shachi-lab/jjy_sim/hardware/case_3d/r3/JJY_SIM_R3_Bottom.png

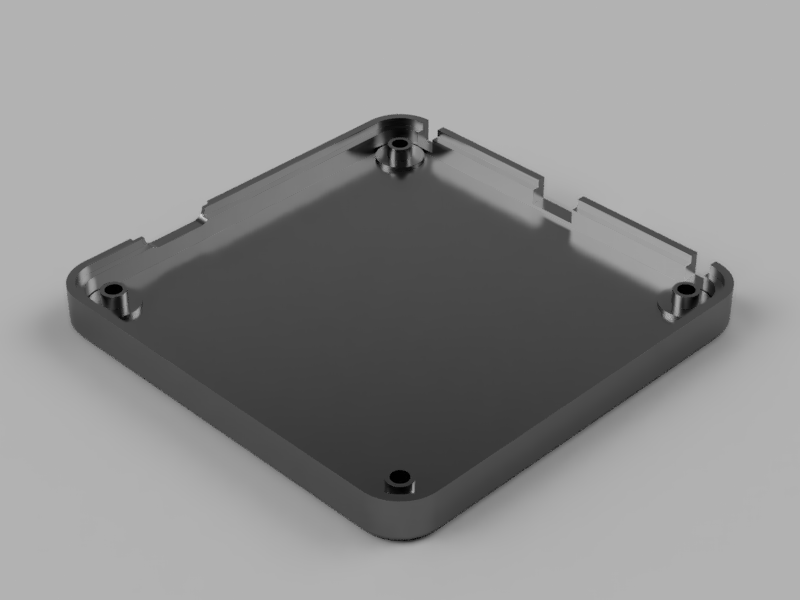
hardware/case_3d/r3/JJY_SIM_R3_Bottom.png
