shachi-lab/jjy_sim/hardware/case_3d/r3/JJY_SIM_R3_Top.step

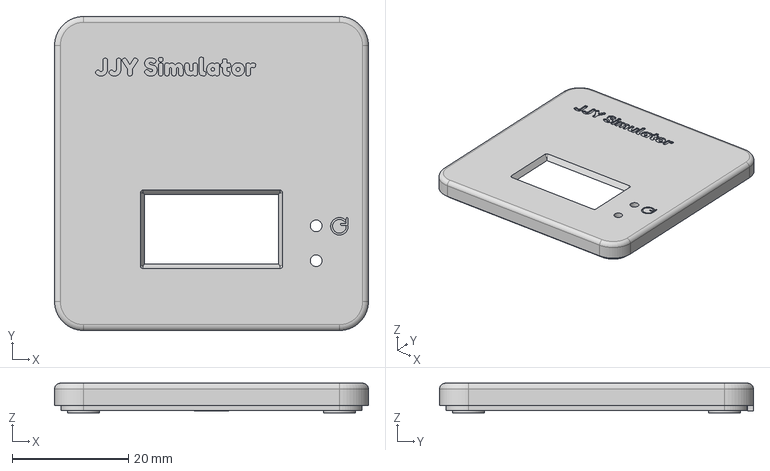
[picture p6: CAD file, 2026-10-26]
hardware/case_3d/r3/JJY_SIM_R3_Top.step
54.0 x 54.0 x 5.10 mm
