shachi-lab/jjy_sim/hardware/case_3d/r4/JJY_SIM_R4_Top.step

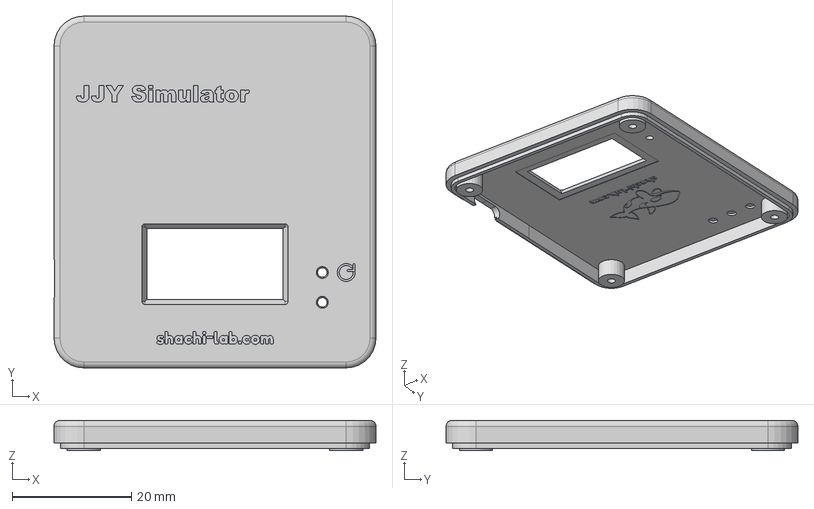
[picture p7: CAD file, 2026-10-26]
hardware/case_3d/r4/JJY_SIM_R4_Top.step
54.0 x 59.0 x 5.10 mm
