shachi-lab/jjy_sim/hardware/KiCad/r4/jjy_sim_r4.kicad_pcb

## KiCad design hardware/KiCad/r4/jjy_sim_r4.kicad_pcb (2026-10-26)

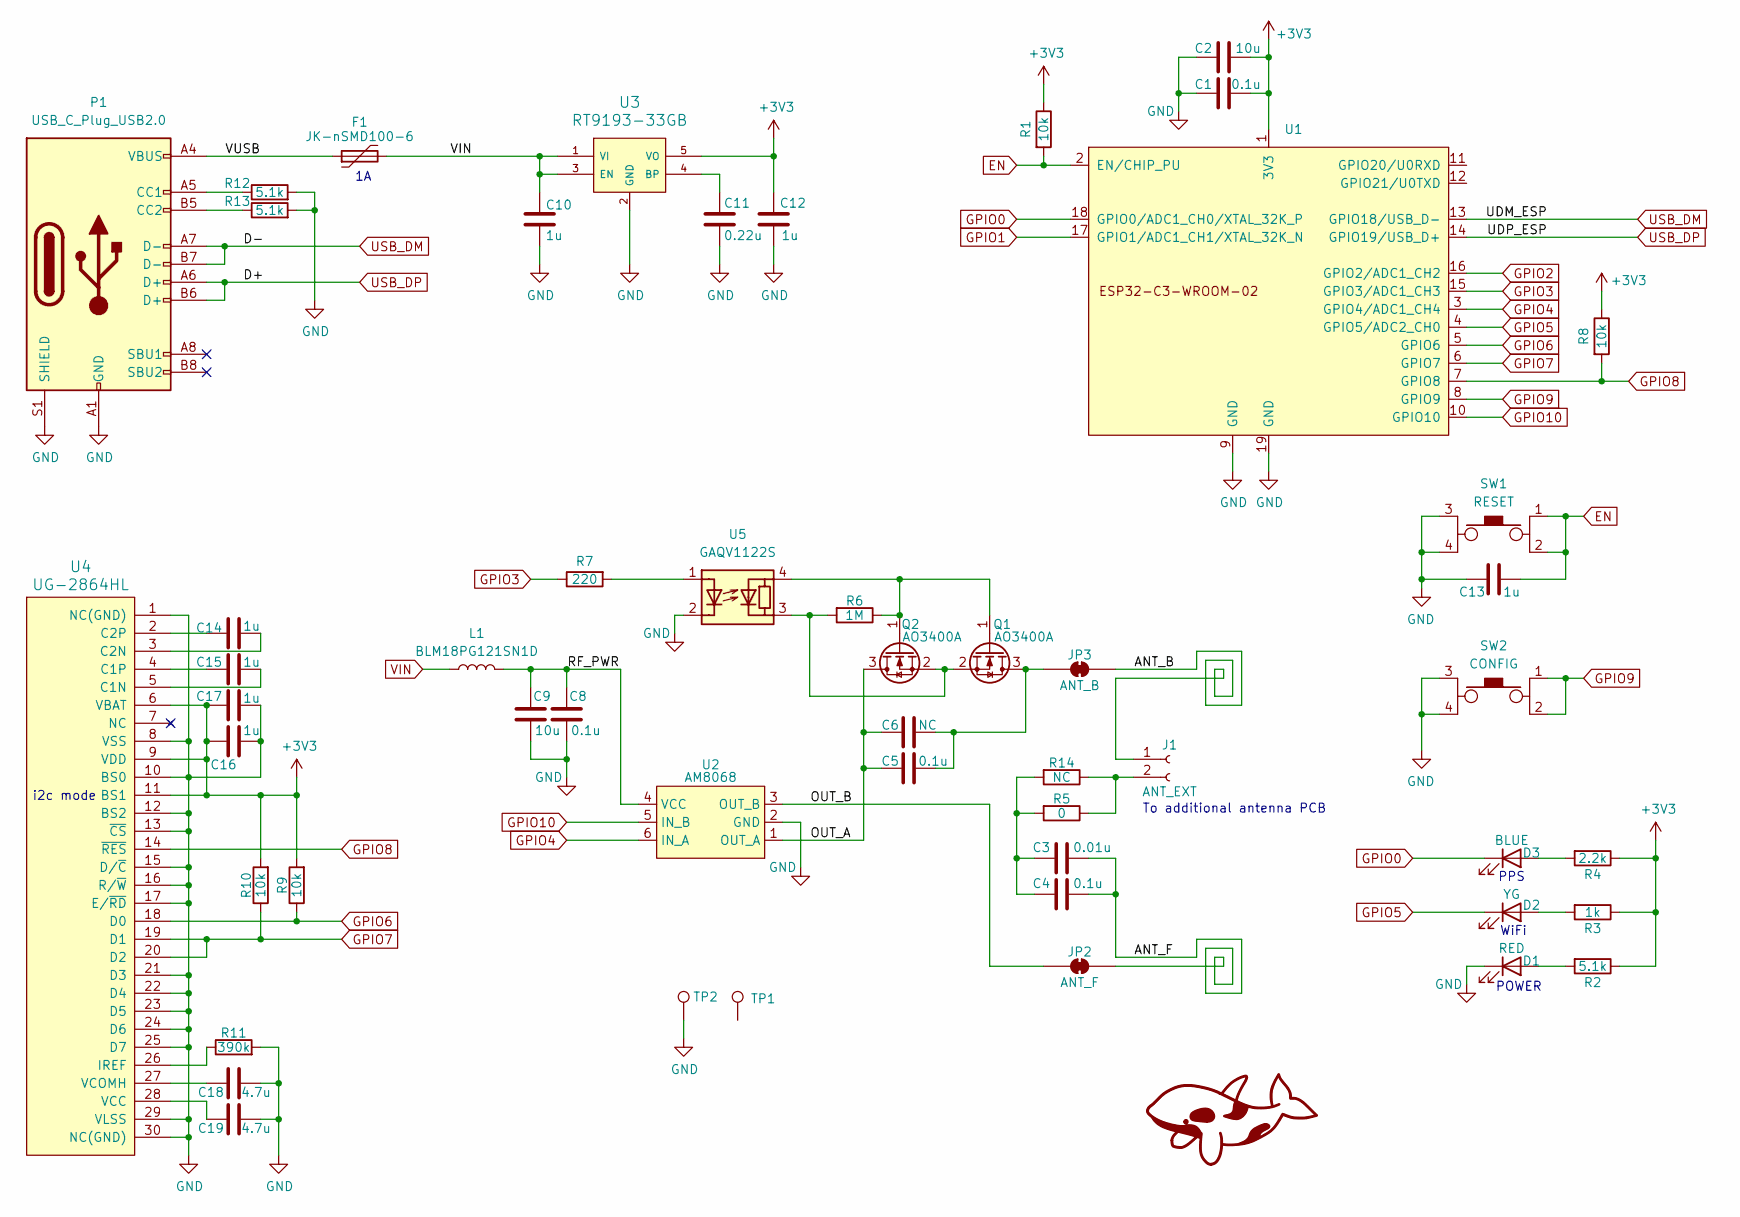
[picture p10: schematic jjy_sim_r4.kicad_sch, JJY Simulator R4]

Parts:
C1, C4, C5, C8: 0.1u; C_0603_1608Metric
C2, C9: 10u; C_0805_2012Metric
C3: 0.01u; C_0603_1608Metric
C6: NC; C_0603_1608Metric
C10, C12, C13, C14, C15, C16, C17: 1u; C_0603_1608Metric
C11: 0.22u; C_0603_1608Metric
C18, C19: 4.7u; C_0603_1608Metric
D1: RED; LED_0603_1608Metric
D2: YG; LED_0603_1608Metric
D3: BLUE; LED_0603_1608Metric
F1: JK-nSMD100-6; Fuse_1206_3216Metric
J1: ANT_EXT; PinHeader_1x02_P2.00mm_Vertical
JP2: ANT_F; SolderJumper-2_P1.3mm_Bridged2Bar_RoundedPad1.0x1.5mm
JP3: ANT_B; SolderJumper-2_P1.3mm_Bridged2Bar_RoundedPad1.0x1.5mm
L1: BLM18PG121SN1D; L_0603_1608Metric
P1: USB_C_Plug_USB2.0; 5077CR-16SMC2-BK-TR
Q1, Q2: AO3400A; SOT-23
R1, R8, R9, R10: 10k; R_0603_1608Metric
R2, R12, R13: 5.1k; R_0603_1608Metric
R3: 1k; R_0603_1608Metric
R4: 2.2k; R_0603_1608Metric
R5: 0; R_0603_1608Metric
R6: 1M; R_0603_1608Metric
R7: 220; R_0603_1608Metric
R11: 390k; R_0603_1608Metric
R14: NC; R_2512_6332Metric
SW1: RESET; SKRPACE010
SW2: CONFIG; SKRPACE010
TP1, TP2: ANT_EX; TestPoint_THTPad_D1.0mm_Drill0.5mm
U1: ESP32-C3-WROOM-02
U2: AM8068; SOT-23-6
U3: RT9193-33GB; SOT-23-5
U4: UG-2864HL; UG-2864-FPC (Reverse)
U5: GAQV1122S; SOP-4_3.8x4.1mm_P2.54mm

Connections:
+3V3: C1.2, C2.2, C12.1, C16.1, C17.1, R1.1, R2.1, R3.1, R4.1, R8.1, R9.2, R10.2, U1.1 (3V3), U3.5 (VO), U4.6 (VBAT), U4.9 (VDD), U4.11 (BS1)
/ANT_B: J1.1, JP3.2 (B)
/ANT_F: C3.2, C4.2, JP2.2 (B)
/OUT_A: C5.1, C6.1, Q2.3 (D), U2.1 (OUT_A)
/OUT_B: JP2.1 (A), U2.3 (OUT_B)
/RF_PWR: C8.1, C9.1, L1.2, U2.4 (VCC)
/VUSB: F1.1, P1.A4 (VBUS), P1.A9 (VBUS), P1.B4 (VBUS), P1.B9 (VBUS)
EN: C13.2, R1.2, SW1.1, SW1.2, U1.2 (EN/CHIP_PU)
GND: C1.1, C2.1, C8.2, C9.2, C10.2, C11.2, C12.2, C13.1, C16.2, C17.2, C18.2, C19.2, D1.1 (K), P1.A1 (GND), P1.A12 (GND), P1.B1 (GND), P1.B12 (GND), P1.S1 (SHIELD), R11.2, R12.2, R13.2, SW1.3, SW1.4, SW2.3, SW2.4, TP2.1 (1_1), U1.9 (GND), U1.19 (GND), U2.2 (GND), U3.2 (GND), U4.1 (NC(GND)), U4.8 (VSS), U4.10 (BS0), U4.12 (BS2), U4.13 (~CS), U4.15 (D/~C), U4.16 (R/~W), U4.17 (E/~RD), U4.21 (D3), U4.22 (D4), U4.23 (D5), U4.24 (D6), U4.25 (D7), U4.29 (VLSS), U4.30 (NC(GND)), U5.2 (K)
GPIO0: D3.1 (K), U1.18 (GPIO0/ADC1_CH0/XTAL_32K_P)
GPIO1: U1.17 (GPIO1/ADC1_CH1/XTAL_32K_N)
GPIO2: U1.16 (GPIO2/ADC1_CH2)
GPIO3: R7.1, U1.15 (GPIO3/ADC1_CH3)
GPIO4: U1.3 (GPIO4/ADC1_CH4), U2.6 (IN_A)
GPIO5: D2.1 (K), U1.4 (GPIO5/ADC2_CH0)
GPIO6: R9.1, U1.5 (GPIO6), U4.18 (D0)
GPIO7: R10.1, U1.6 (GPIO7), U4.19 (D1), U4.20 (D2)
GPIO8: R8.2, U1.7 (GPIO8), U4.14 (~RES)
GPIO9: SW2.1, SW2.2, U1.8 (GPIO9)
GPIO10: U1.10 (GPIO10), U2.5 (IN_B)
unnamed: C3.1, C4.1, R5.2, R14.2
unnamed: D1.2 (A), R2.2
unnamed: D2.2 (A), R3.2
unnamed: D3.2 (A), R4.2
unnamed: J1.2, R5.1, R14.1
unnamed: C5.2, C6.2, JP3.1 (A), Q1.3 (D)
unnamed: P1.A5 (CC1), R12.1
unnamed: P1.B5 (CC2), R13.1
unnamed: Q1.1 (G), Q2.1 (G), R6.1, U5.4 (R)
unnamed: Q1.2 (S), Q2.2 (S), R6.2, U5.3 (R)
unnamed: C11.1, U3.4 (BP)
unnamed: C15.2, U4.5 (C1N)
unnamed: C15.1, U4.4 (C1P)
unnamed: C14.2, U4.3 (C2N)
unnamed: C14.1, U4.2 (C2P)
unnamed: R11.1, U4.26 (IREF)
unnamed: C19.1, U4.28 (VCC)
unnamed: C18.1, U4.27 (VCOMH)
unnamed: R7.2, U5.1 (A)
USB_DM: P1.A7 (D-), P1.B7 (D-), U1.13 (GPIO18/USB_D-)
USB_DP: P1.A6 (D+), P1.B6 (D+), U1.14 (GPIO19/USB_D+)
VIN: C10.1, F1.2, L1.1, U3.1 (VI), U3.3 (EN)

Notes on the sheet:
To additional antenna PCB
PPS
i2c mode
WiFi
POWER

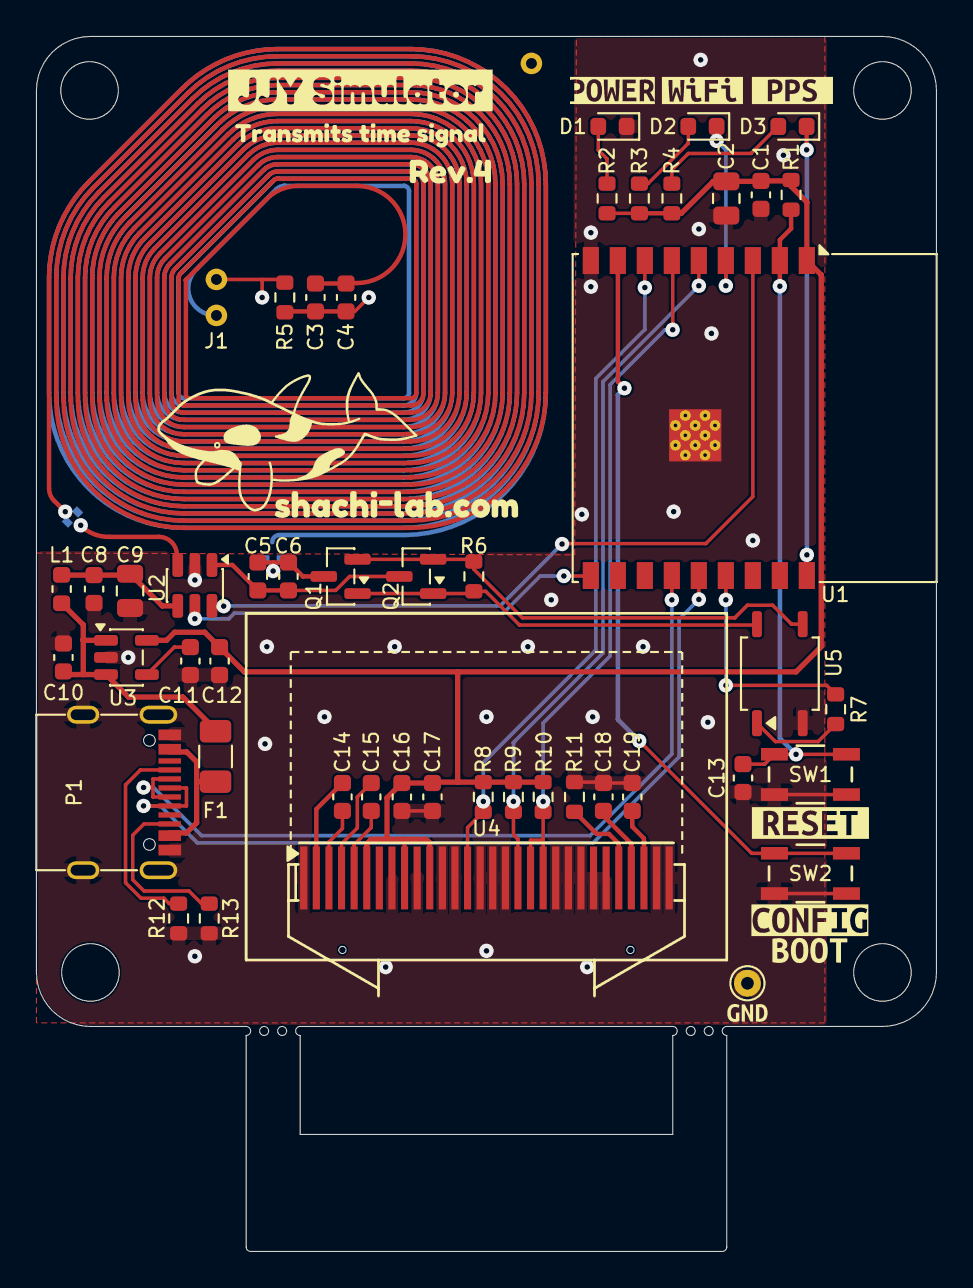
[picture p11: board jjy_sim_r4.kicad_pcb from above]

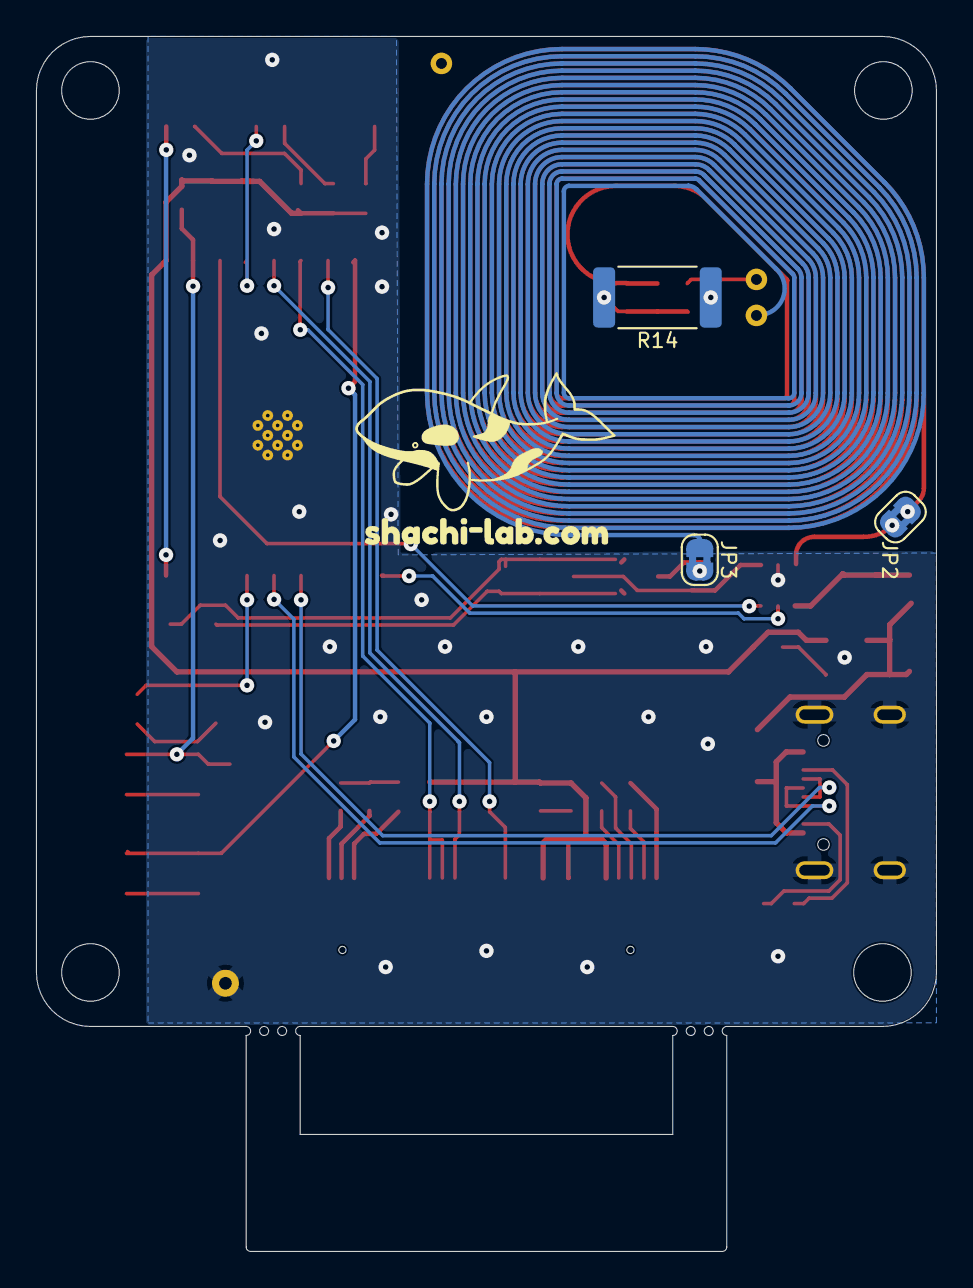
[picture p12: board jjy_sim_r4.kicad_pcb from below]

Board: 2 copper layers, 50.0 x 67.5 mm, 68 parts (4 on the bottom side), 40 nets.

Other parts of the board:
1, 2, 3, 4: (no value)
kibuzzard-1: G***; kibuzzard-68D3A9C1
kibuzzard-2: G***; kibuzzard-6A7AED3A
kibuzzard-3: G***; kibuzzard-6A7AED45
kibuzzard-4: G***; kibuzzard-6A7AED2D
kibuzzard-5: G***; kibuzzard-68D3A910
kibuzzard-6: G***; kibuzzard-6A7AE0A2
kibuzzard-7, kibuzzard-12: G***; kibuzzard-68D2B4BB
kibuzzard-8: G***; kibuzzard-665B3587
kibuzzard-9: G***; kibuzzard-665B357F
kibuzzard-10: G***; kibuzzard-669B16B9
kibuzzard-11: G***; kibuzzard-665B35AE
