shachi-lab/jjy_sim/hardware/KiCad/r3/jjy_sim_r3.kicad_pcb

## KiCad design hardware/KiCad/r3/jjy_sim_r3.kicad_pcb (2026-10-26)

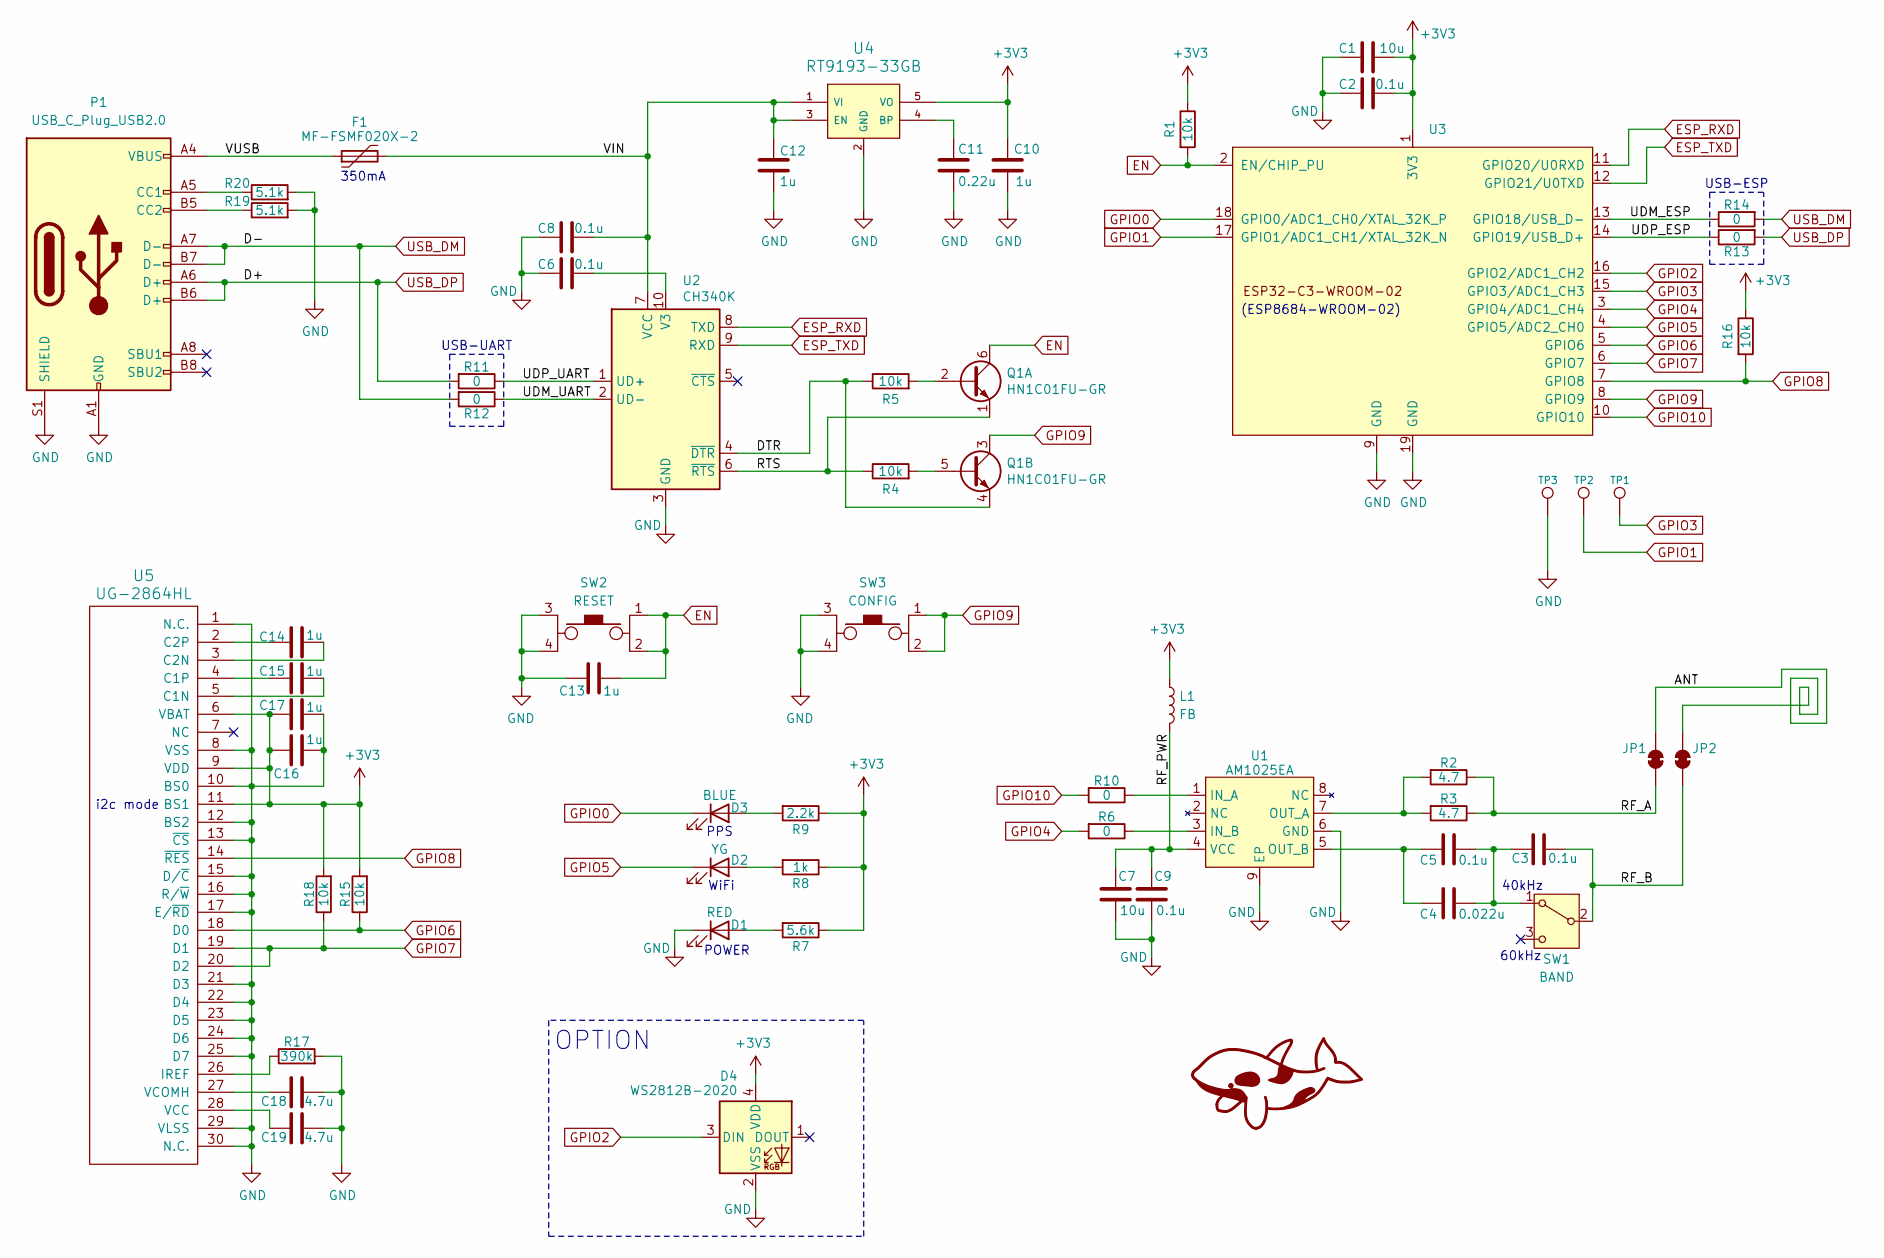
[picture p13: schematic jjy_sim_r3.kicad_sch, JJY Simulator R3]

Parts:
C1, C7: 10u; C_0805_2012Metric
C2, C3, C5, C6, C8, C9: 0.1u; C_0603_1608Metric
C4: 0.022u; C_0603_1608Metric
C10, C12, C13, C14, C15, C16, C17: 1u; C_0603_1608Metric
C11: 0.22u; C_0603_1608Metric
C18, C19: 4.7u; C_0603_1608Metric
D1: RED; LED_0603_1608Metric
D2: YG; LED_0603_1608Metric
D3: BLUE; LED_0603_1608Metric
D4: WS2812B-2020; LED_WS2812B-2020_PLCC4_2.0x2.0mm
F1: MF-FSMF020X-2; Fuse_1206_3216Metric_Pad1.42x1.75mm_HandSolder
JP1: ANT-A; Jumper-2_TH_3.81mm
JP2: GND; Jumper-2_TH_3.81mm
L1: FB; L_0603_1608Metric
P1: USB_C_Plug_USB2.0; 5077CR-16SMC2-BK-TR_Ext
Q1: HN1C01FU-GR; 2-2J1A
R1, R4, R5, R15, R16, R18: 10k; R_0603_1608Metric
R2, R3: 4.7; R_0603_1608Metric
R6, R10, R11, R12, R13, R14: 0; R_0603_1608Metric
R7: 5.6k; R_0603_1608Metric
R8: 1k; R_0603_1608Metric
R9: 2.2k; R_0603_1608Metric
R17: 390k; R_0603_1608Metric
R19, R20: 5.1k; R_0603_1608Metric
SW1: BAND; MSK-12C02
SW2: RESET; SKRPACE010
SW3: CONFIG; SKRPACE010
TP1, TP2, TP3: TP; TestPoint_THTPad_D1.5mm_Drill0.7mm
U1: AM1025EA; eSOP-8_3.9x5.05mm_EP_3.1x2.2mm_P1.27mm
U2: CH340K; SSOP-10-1EP_3.9x4.9mm_P1mm_EP2.1x3.3mm
U3: ESP32-C3-WROOM-02; ESP32-C3-WROOM-02,ESP8684-WROOM-2C
U4: RT9193-33GB; SOT-23-5
U5: UG-2864HL; UG-2864-FPC (Reverse)

Connections:
+3V3: C1.2, C2.2, C10.1, C16.1, C17.1, D4.4 (VDD), L1.1, R1.1, R7.1, R8.1, R9.1, R15.2, R16.1, R18.2, U3.1 (3V3), U4.5 (VO), U5.6 (VBAT), U5.9 (VDD), U5.11 (BS1)
/ANT: JP1.2 (B), JP2.2 (B)
/DTR: Q1.4 (E2), R5.1, U2.4 (~DTR)
/RF_A: JP1.1 (A), R2.1, R3.1
/RF_B: C3.2, JP2.1 (A), SW1.2 (B)
/RF_PWR: C7.1, C9.1, L1.2, U1.4 (VCC)
/RTS: Q1.1 (E1), R4.1, U2.6 (~RTS)
/UDM_ESP: R14.1, U3.13 (GPIO18/USB_D-)
/UDM_UART: R12.1, U2.2 (UD-)
/UDP_ESP: R13.1, U3.14 (GPIO19/USB_D+)
/UDP_UART: R11.1, U2.1 (UD+)
/VIN: C8.2, C12.1, F1.2, U2.7 (VCC), U4.1 (VI), U4.3 (EN)
/VUSB: F1.1, P1.A4 (VBUS), P1.A9 (VBUS), P1.B4 (VBUS), P1.B9 (VBUS)
EN: C13.2, Q1.6 (C1), R1.2, SW2.1, SW2.2, U3.2 (EN/CHIP_PU)
ESP_RXD: U2.8 (TXD), U3.11 (GPIO20/U0RXD)
ESP_TXD: U2.9 (RXD), U3.12 (GPIO21/U0TXD)
GND: C1.1, C2.1, C6.1, C7.2, C8.1, C9.2, C10.2, C11.2, C12.2, C13.1, C16.2, C17.2, C18.2, C19.2, D1.1 (K), D4.2 (VSS), P1.A1 (GND), P1.A12 (GND), P1.B1 (GND), P1.B12 (GND), P1.S1 (SHIELD), R17.2, R19.2, R20.2, SW2.3, SW2.4, SW3.3, SW3.4, TP3.1 (1_1), U1.6 (GND), U1.9 (EP), U2.3 (GND), U2.11 (GND), U3.9 (GND), U3.19 (GND), U4.2 (GND), U5.1 (NC(GND)), U5.8 (VSS), U5.10 (BS0), U5.12 (BS2), U5.13 (~CS), U5.15 (D/~C), U5.16 (R/~W), U5.17 (E/~RD), U5.21 (D3), U5.22 (D4), U5.23 (D5), U5.24 (D6), U5.25 (D7), U5.29 (VLSS), U5.30 (NC(GND))
GPIO0: D3.1 (K), U3.18 (GPIO0/ADC1_CH0/XTAL_32K_P)
GPIO1: TP2.1 (1_1), U3.17 (GPIO1/ADC1_CH1/XTAL_32K_N)
GPIO2: D4.3 (DIN), U3.16 (GPIO2/ADC1_CH2)
GPIO3: TP1.1 (1_1), U3.15 (GPIO3/ADC1_CH3)
GPIO4: R6.2, U3.3 (GPIO4/ADC1_CH4)
GPIO5: D2.1 (K), U3.4 (GPIO5/ADC2_CH0)
GPIO6: R15.1, U3.5 (GPIO6), U5.18 (D0)
GPIO7: R18.1, U3.6 (GPIO7), U5.19 (D1), U5.20 (D2)
GPIO8: R16.2, U3.7 (GPIO8), U5.14 (~RES)
GPIO9: Q1.3 (C2), SW3.1, SW3.2, U3.8 (GPIO9)
GPIO10: R10.2, U3.10 (GPIO10)
unnamed: D1.2 (A), R7.2
unnamed: D2.2 (A), R8.2
unnamed: D3.2 (A), R9.2
unnamed: P1.A5 (CC1), R20.1
unnamed: P1.B5 (CC2), R19.1
unnamed: Q1.2 (B1), R5.2
unnamed: Q1.5 (B2), R4.2
unnamed: C3.1, C4.2, C5.2, SW1.1 (A)
unnamed: R10.1, U1.1 (IN_A)
unnamed: R6.1, U1.3 (IN_B)
unnamed: R2.2, R3.2, U1.7 (OUT_A)
unnamed: C4.1, C5.1, U1.5 (OUT_B)
unnamed: C11.1, U4.4 (BP)
unnamed: C15.2, U5.5 (C1N)
unnamed: C15.1, U5.4 (C1P)
unnamed: C14.2, U5.3 (C2N)
unnamed: C14.1, U5.2 (C2P)
unnamed: R17.1, U5.26 (IREF)
unnamed: C19.1, U5.28 (VCC)
unnamed: C18.1, U5.27 (VCOMH)
unnamed: C6.2, U2.10 (V3)
USB_DM: P1.A7 (D-), P1.B7 (D-), R12.2, R14.2
USB_DP: P1.A6 (D+), P1.B6 (D+), R11.2, R13.2

Notes on the sheet:
USB-UART
PPS
OPTION
350mA
i2c mode
60kHz
USB-ESP
WiFi
40kHz
POWER
(ESP8684-WROOM-02)

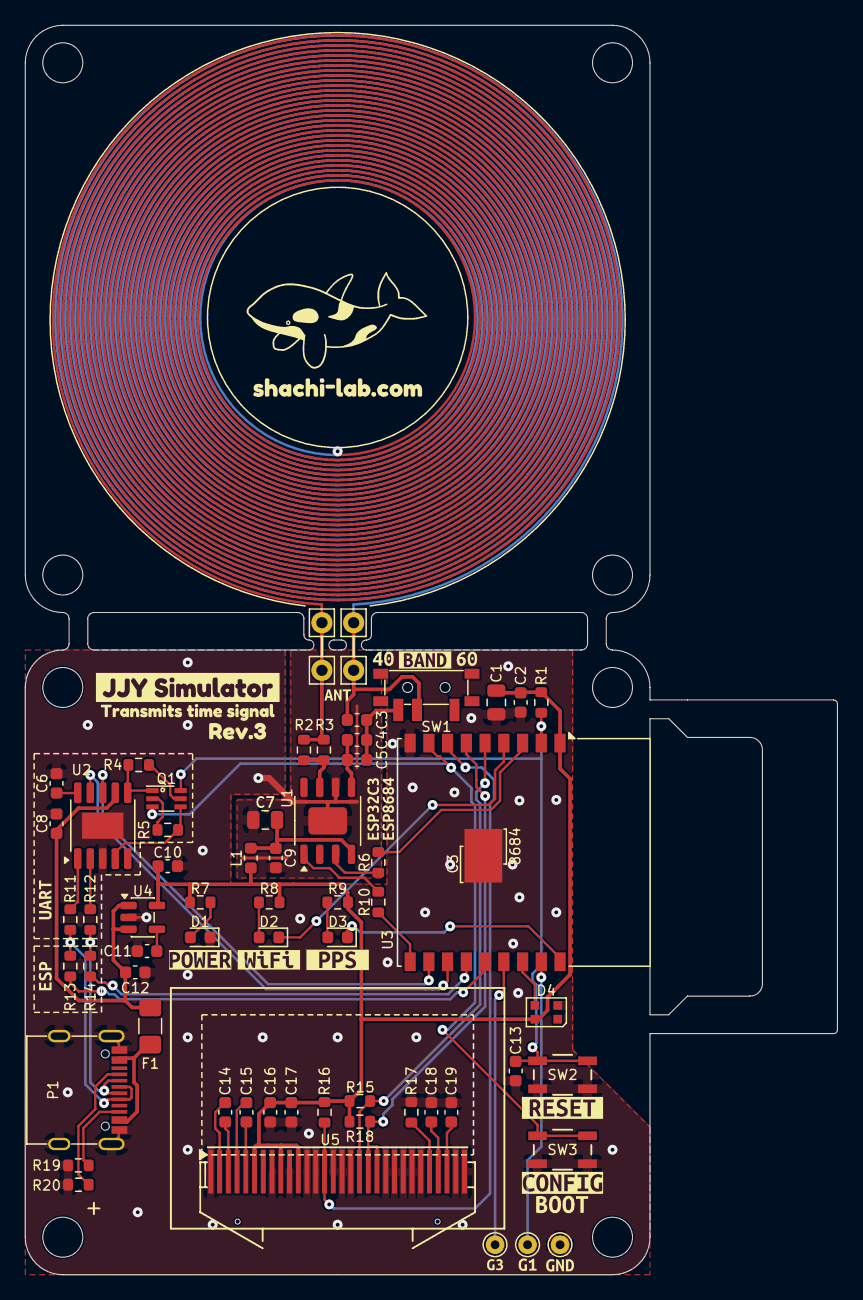
[picture p14: board jjy_sim_r3.kicad_pcb from above]

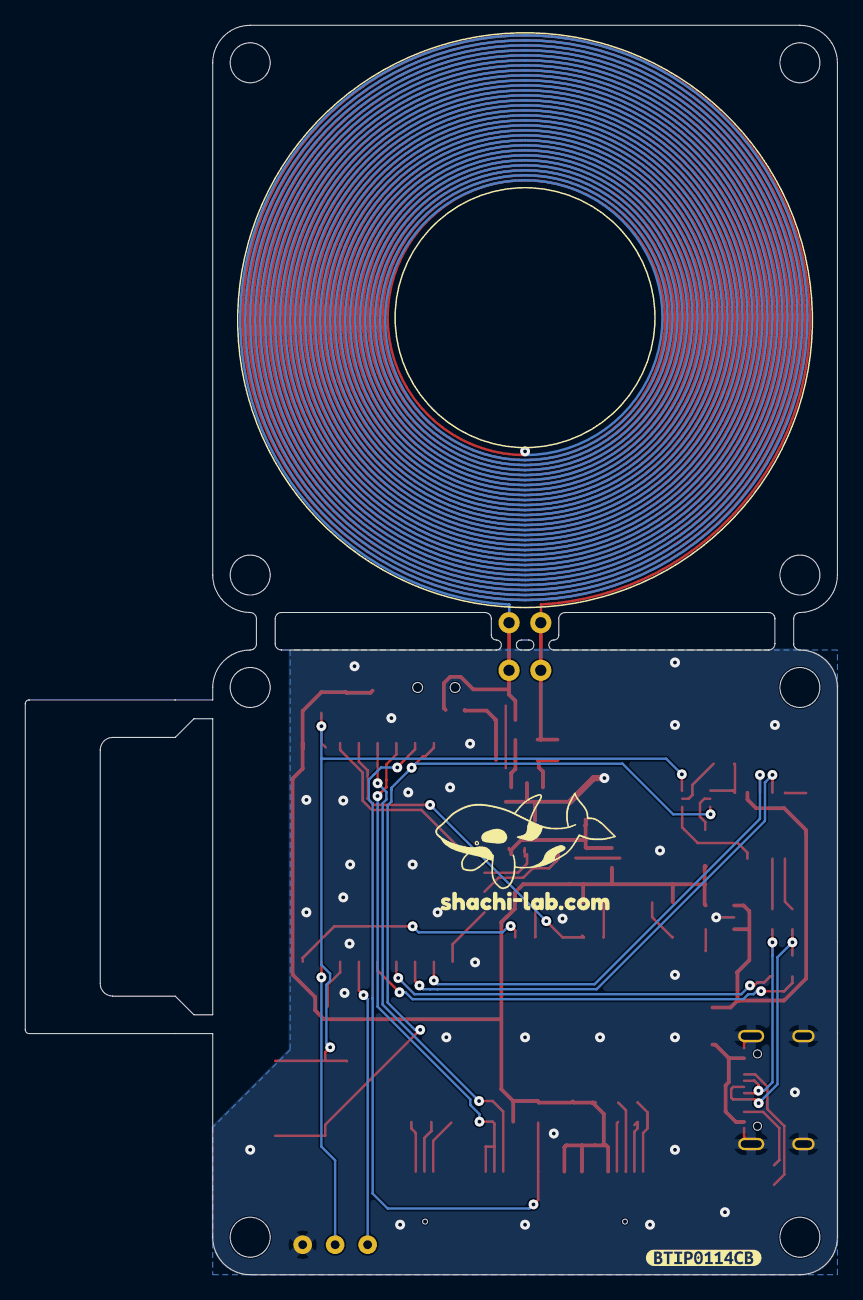
[picture p15: board jjy_sim_r3.kicad_pcb from below]

Board: 2 copper layers, 65.0 x 100.0 mm, 90 parts (2 on the bottom side), 51 nets.

Other parts of the board:
1, 2, 3, 4, 5, 6, 7, 8: (no value)
kibuzzard-1, kibuzzard-28: G***; kibuzzard-68D2B4BB
kibuzzard-2: G***; kibuzzard-6982098F
kibuzzard-3: G***; kibuzzard-69820977
kibuzzard-4: G***; kibuzzard-69820ADF
kibuzzard-5: G***; kibuzzard-68D3A9C1
kibuzzard-6: G***; kibuzzard-6646C6AC
kibuzzard-6A179A92: G***; kibuzzard-6A179A92
kibuzzard-7: G***; kibuzzard-68D3A910
kibuzzard-8: G***; kibuzzard-69816480
kibuzzard-9: G***; kibuzzard-69867CAB
kibuzzard-10: G***; kibuzzard-698209E3
kibuzzard-11: G***; kibuzzard-669B6BC9
kibuzzard-12: G***; kibuzzard-669B6DC4
kibuzzard-13: G***; kibuzzard-68E061D7
kibuzzard-14: G***; kibuzzard-69965DBC
kibuzzard-15: G***; kibuzzard-665B3587
kibuzzard-16: G***; kibuzzard-665B357F
kibuzzard-17: G***; kibuzzard-669B16B9
kibuzzard-18: G***; kibuzzard-665A8DD6
kibuzzard-19: G***; kibuzzard-669B4532
kibuzzard-20: G***; kibuzzard-665B35AE
