shachi-lab/jjy_sim/firmware/idf/jjy-sim/main/esp_efuse_custom_table.c

/*
 * SPDX-FileCopyrightText: 2017-2026 Espressif Systems (Shanghai) CO LTD
 *
 * SPDX-License-Identifier: Apache-2.0
 */

#include "sdkconfig.h"
#include "esp_efuse.h"
#include <assert.h>
#include "esp_efuse_custom_table.h"

// md5_digest_table 452fa30594b2ddbb69a2777d772832ea
// This file was generated from the file esp_efuse_custom_table.csv. DO NOT CHANGE THIS FILE MANUALLY.
// If you want to change some fields, you need to change esp_efuse_custom_table.csv file
// then run `efuse_common_table` or `efuse_custom_table` command it will generate this file.
// To show efuse_table run the command 'show_efuse_table'.

static const esp_efuse_desc_t USER_DATA_JJYSIM_HW_GENERATION[] = {
    {EFUSE_BLK3, 0, 8}, 	 // JJY-SIM hardware generation,
};





const esp_efuse_desc_t* ESP_EFUSE_USER_DATA_JJYSIM_HW_GENERATION[] = {
    &USER_DATA_JJYSIM_HW_GENERATION[0],    		// JJY-SIM hardware generation
    NULL
};
