shachi-lab/jjy_sim/(commit log)

2026-10-26 Prepare JJY-SIM v1.2.0 firmware and R4 design sources
    Export the shared ESP-IDF 5.5.4 firmware under firmware/idf/jjy-sim,
    including OTA updates, the LAN NTP server, screen saver, STA setup access,
    and current Wi-Fi/OTA fixes. Keep portable build settings and the public
    placeholder storage key; exclude distribution tools and generated files.
    Include the prepared R3/R4/R4.1 and antenna board designs, shared KiCad
    libraries, Gerbers, case models, photographs, and Japanese/English READMEs.
    Validation: public-source ESP32-C2 and ESP32-C3 builds pass; local README
    references resolve. WORK and its private storage key remain unchanged.
2026-10-27 Fix R4 photo filename case for README images
